jblang/TMS9918A/tmsmandel.jpg

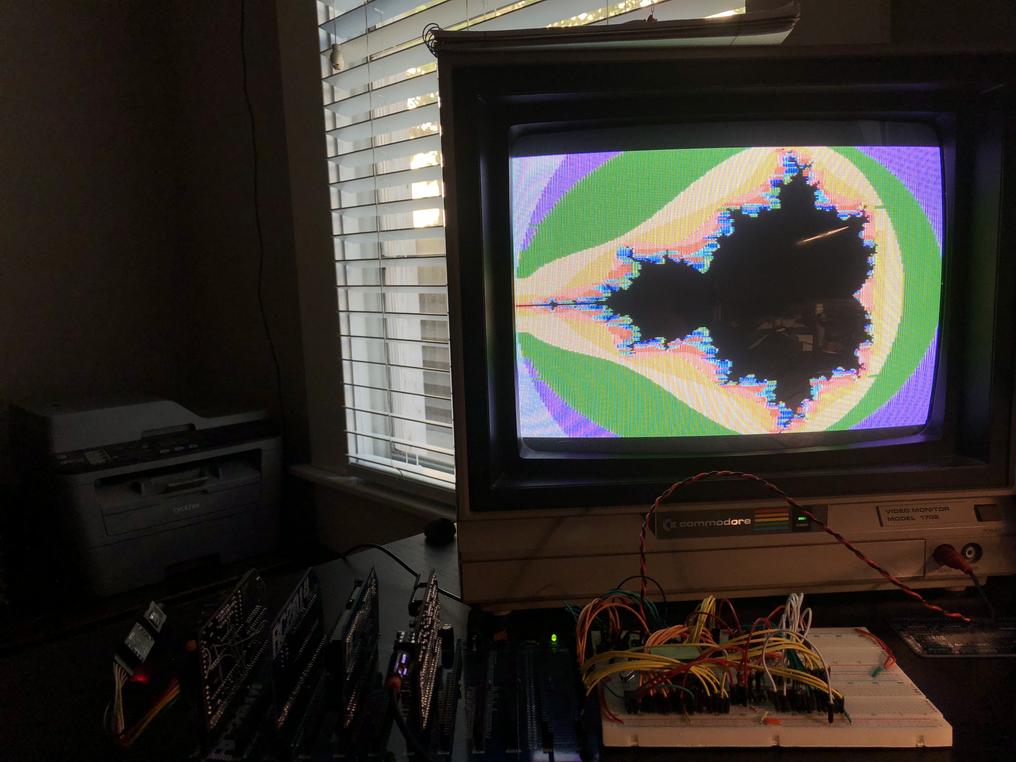
tmsmandel.jpg
