jblang/TMS9918A/(threads)

Thread 4 (2019-03-12):

Ask for clarification: why do we need a voltage buffer for COMVID

apoloval, 2019-03-12:
According to the schematic, there is a NPN, emitter-follower transistor circuit that seems to be there as a voltage buffer for COMVID signal.

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

Thanks to this buffer, we may have a low output impedance. However, according to the TMS9918 datasheet, the VDP already have a MOS source-follower that would do exactly the same the NPN is doing.

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

My question is, why do we need such NPN circuit for COMVID?

Thanks in advance for your help.

jblang, 2019-03-15:
As I stated in the README, I started with a circuit designed by [Tom LeMense](https://retrobrewcomputers.org/n8vem-pbwiki-archive/0/35845334/48860720/33053543/SRAM%20Replacement%20for%20TMS99x8%20VRAM.pdf) and simply added address decoding and laid it out on a PCB. I did not put much thought into why he designed the output stage the way he did; I just copied it verbatim. You are right that it may not be necessary.

apoloval, 2019-03-18:
Okay. Thank you so much for your response. It is really interesting, since most of the circuits I've seen using TMS9918 use a transistor at COMVID output. I will try to contact Tom to see if he could clarify this.

Again, thank you so much for your time! And congrats for this awesome project!

justinmoor, 2022-04-24:
Same question here. I've got a 100% working VDP with SRAM interfaced to a 6502 without the voltage buffer circuit or ferrite bead. COMVID is directly connected (with 470 ohm resistor) to the video input of the monitor (Sony PVM). Everything seems to be working fine. Any update on this?

apoloval, 2022-04-25:
I emailed Tom in 2019 asking the same question here. But I am afraid I received no response.

I still don't know why this output stage. But I also confirm I have working designs that do not have it.

cbmeeks, 2022-04-27:
For the record, I've also connected just a 330 ohm resistor from COMVID to GND and it worked just fine on a vanilla TV.  In fact, it was very colorful and vibrant.

apoloval, 2022-04-28:
In my case I am using 470 Ohms, also with nice results:

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

The design is open source, available in https://github.com/artemisamsx/gfx9918.

michaelkamprath, 2022-04-28:
Section 3.4.1 and 4.2.2 of [the TMS9918A spec](http://www1.cs.columbia.edu/~sedwards/papers/TMS9918.pdf) clearly states that in most cases, a 330 Ω or 470 Ω pull down resistor on the COMVID line is what is needed in most cases. But they also states that "in some cases it may be necessary to provide a simple interface circuit to match the monitor's input requirements." The use of the transistor on the COMVID line is that circuit, and it there as a simple precaution as it electrically isolates the rare, expensive, and no longer produced TMS9918A chip from external electrical interfaces. If the monitor draws more current than the TMS9918A can supply, well, that doesn't happen with the transistor circuit in this card's current design. Is it strictly needed? No. Does adding a 25 cent (if that) part provide some electrical isolation for the TMSD9918A chip? Yes.

apoloval, 2022-04-28:
I find the usage of the buffer for protection purposes convincing. Just wanted to know if there was anything else.

justinmoor, 2022-05-03:
Clear story. Thanks for commenting all!

Closed 2019-03-18.

Thread 6 (2020-09-19):

ym2149 jumper settings for nyan cat demo

quarterturn, 2020-09-19:
I have the nyan cat demo running on my Z180 ROMWBW "Black Adder" system but the audio from the YM2149 sounds way too low in pitch. The pace seems about right. What jumper settings on the YM2149 sound card did you use? I tried the default and the SC settings, but both work the same.

I  haven't yet tested the YM2149 board with other code, but I have tested the chip used in an Atmel setup where it plays ym stuff fine.

jblang, 2021-01-16:
I am using the REV6 of the YM2149 board that has its own 3.58MHz clock source.  If you have REV5 or earlier, you should configure your clock divider jumpers so that you can get the clock as close to 3.58MHz as possible based on the frequency of the system clock.

quarterturn, 2021-01-18:
Thank you I have resolved this by making a daughterboard for my YM2149 card that contains a 3.58 MHz oscillator. It works fine now.

Closed 2021-01-18.

Thread 9 (2021-01-16):

Operation with single-row RC2014 bus ?  (with possible answer...)

rwdavis3rd, 2021-01-16:
I'd looked forward to operating this TMS9918a video card as part of an SC130 (Z180) configuration.  I was a little disturbed to observe that video card made some use of (some-of) the second-row of RC2014 bus pins, which suggested it was not a fit for the single-row SC130 implementation.

After some study of the video card schematic, it appears that the video card taps the 2nd row simply for access to Z80's NMI.   And studying the cards jumper settings, I further learn that the use of NMI is usually only prescribed when _another_ board on the RC2014 bus is already using the conventional (maskable) INT signal.

jblang, or real-world testing, may prove me wrong, but... it appears that others (like me) who have single-row RC2014 "Z80" busses can proceed with confidence in most cases.  And for my part, if I later discover a need for the TMS9918a to tap the NMI line, I'll probably just float a wire to implement this signal path.

Sound right?

Thanks for any thoughts, and (_more_ importantly) thanks for making the venerated TMS9981 graphics readily accessible to geeks like me.

jblang, 2021-01-16:
Yes, it should work with only the single row header if you don't need NMI.  ColecoVision software requires the use of NMI, but if you don't care about that, you don't need it.

The INT line can be shared as long as you have REV4 of the board or later. It has a diode to convert the INT line to an open drain output.  That solves the hardware issue, but software in this case has to be programmed to check the registers of every device that might generate an interrupt to determine which one it has to service. Also, it is only compatible with the Z80's interrupt mode 1.

Thread 10 (2021-02-18):

What value did you use for the ferrite bead and R0 resistor?

cbmeeks, 2021-02-18:
I believe this is mostly based on the "SRAM Replacement" document for the TMS9918.  In that design, there is a ferrite bead used on VCC and the TMS9918.

I am building a similar design and was wondering what value you used?

Also, there is a 0 ohm resistor that is used in the original design.  Did you stick with 0 ohms or did you change it to something else?

Thanks

cbmeeks, 2022-04-27:
This can be closed.

I've been able to just use the reference design from TI (330 ohm resistor from COMVID to GND) with nothing else and it looks great.

Closed 2022-04-27.

Thread 12 (2022-10-15):

Modifying the Pageable ROM to work with ColecoVision addressing

ezod, 2022-10-15:
More a solution than an issue, but perhaps this could be added to the documentation somewhere. I have verified this modification works with some limited testing.

The standard RC2014 [Pageable ROM module](https://rc2014.co.uk/modules/pageable-rom/) canonically uses ports `$30` and `$38`, but due to don't-cares all of `$3x` and `$Bx` are assigned to it. Unfortunately, the `$Bx` range conflicts with the ColecoVision ports for the TMS9918A module.

A simple modification to the Pageable ROM module allows the ColecoVision ports to be used. To reduce the address range to just `$3x`, the enable pin on the decoder connected to A6 needs to be replaced with A6 OR A7.

In hardware, a 74HCT32 (quad OR), with all but pins 1, 2, 3, 7, and 14 removed, is piggy-backed on U1, with the power pins (7 and 14) soldered down. Pins 1, 2, and 3 are straightened horizontally for air soldering. Pins 1 and 2 are connected to A7 and A6 on the RC2014 bus, respectively. Pin 4 of U2 is bent out of the socket, and connected to pin 3 of the new 74HCT32.

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

ezod, 2022-10-17:
Confirmed today that this allows me to use @jblang's ColecoVision CP/M loader. (Still have no color video per #13, audio sounds like trash for as-yet unknown reasons, and I have no way to control the games yet, but at least we're past the address conflict!)

Thread 13 (2022-10-15):

No color on composite video output

ezod, 2022-10-15:
I built this module from parts sourced myself without difficulty, but the composite video signal is not displaying color, only grayscale.

A similar issue was discussed [here](https://www.msx.org/forum/msx-talk/hardware/tms9918-not-displaying-color) and [here](https://github.com/InPermutation/tms9918a-arduino/issues/1), and the eventual resolution had to do with the accuracy of the crystal frequency. Indeed, the exact crystal specified in the BOM is no longer available, and I used [this part from Mouser](https://www.mouser.ca/ProductDetail/ECS/ECS-107.3-S-4X?qs=CNVyLAqdhH3eznbdvp7RRg%3D%3D) instead, but based on the datasheets and other implementations this part looks like it should work. Michael Kamprath, who sells the Tindie kits, independently suggested this same part as a replacement. Its datasheet specifies a 20pF load capacitance; I tried the 16pF and 22pF caps I had on hand with the same result in both cases.

Another suggestion was that the TMS9918A (sourced from an eBay seller in China) might in fact be a relabeled TMS9928A or TMS9929A, as these output Y (luminance) on pin 36 instead of COMVID. Perhaps there is a way with just the chip I have to definitively determine whether this is the case? Unfortunately, for the moment, I do not have another TMS9918A on hand to try.

Is there anything else I should check that might be the problem here, before I try my luck with another month-plus wait for a TMS9918A?

apoloval, 2022-10-17:
> Another suggestion was that the TMS9918A (sourced from an eBay seller in China) might in fact be a relabeled TMS9928A or TMS9929A, as these output Y (luminance) on pin 36 instead of COMVID.

I bet for this one.

Do you have an oscilloscope? It is really easy to confirm if you had one.

apoloval, 2022-10-17:
You can make a particular test on pin 35. In TMS9918, this is the `EXTVDP` input signal. While in TMS9928/29 it is `B-Y`, an output signal that contains color information.

If you observe a plain zero signal in the oscilloscope, or a pure noise wave, your part is a TMS9918. If you observe a video-like waveform as the following one, it is a TMS9928/29:

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

ezod, 2022-10-17:
Pin 35 appears to just be a bit of white noise hovering near 5V. It definitely looks different than the signal on pin 36.

ezod, 2022-10-17:
Given that it seems I have a genuine TMS9918, I found [this thread](https://www.retrobrewcomputers.org/n8vem-gg-archive/html-2010/Jan/msg00049.html) discussing a similar issue, suggesting that the crystal frequency isn't the only potential issue. I've ordered a [MP107-E](https://www.digikey.ca/en/products/detail/cts-frequency-controls/MP107-E/2637557) parallel resonant crystal along with some 33pF capacitors (hopefully close enough to the specified 32pF), similar to the part that worked for the OP, and will update here if that works.

ezod, 2022-10-18:
And it works! Closing, but hopefully this will help anyone who encounters this issue in the future.

Closed 2022-10-18.

Thread 14 (2022-12-26):

Trimmer for crystal frequency fine tuning

eluancm, 2022-12-26:
A trimmer capacitor with a reasonable range instead of a fixed capacitor on the TMS9918A pin 40 would be useful to fine-tune the frequency and get good colors.

On one of my aged TVs, I need to put a finger on this pin to get any colors, regardless of fine tuning.
