jblang/TMS9918A/TMS9918.pdf

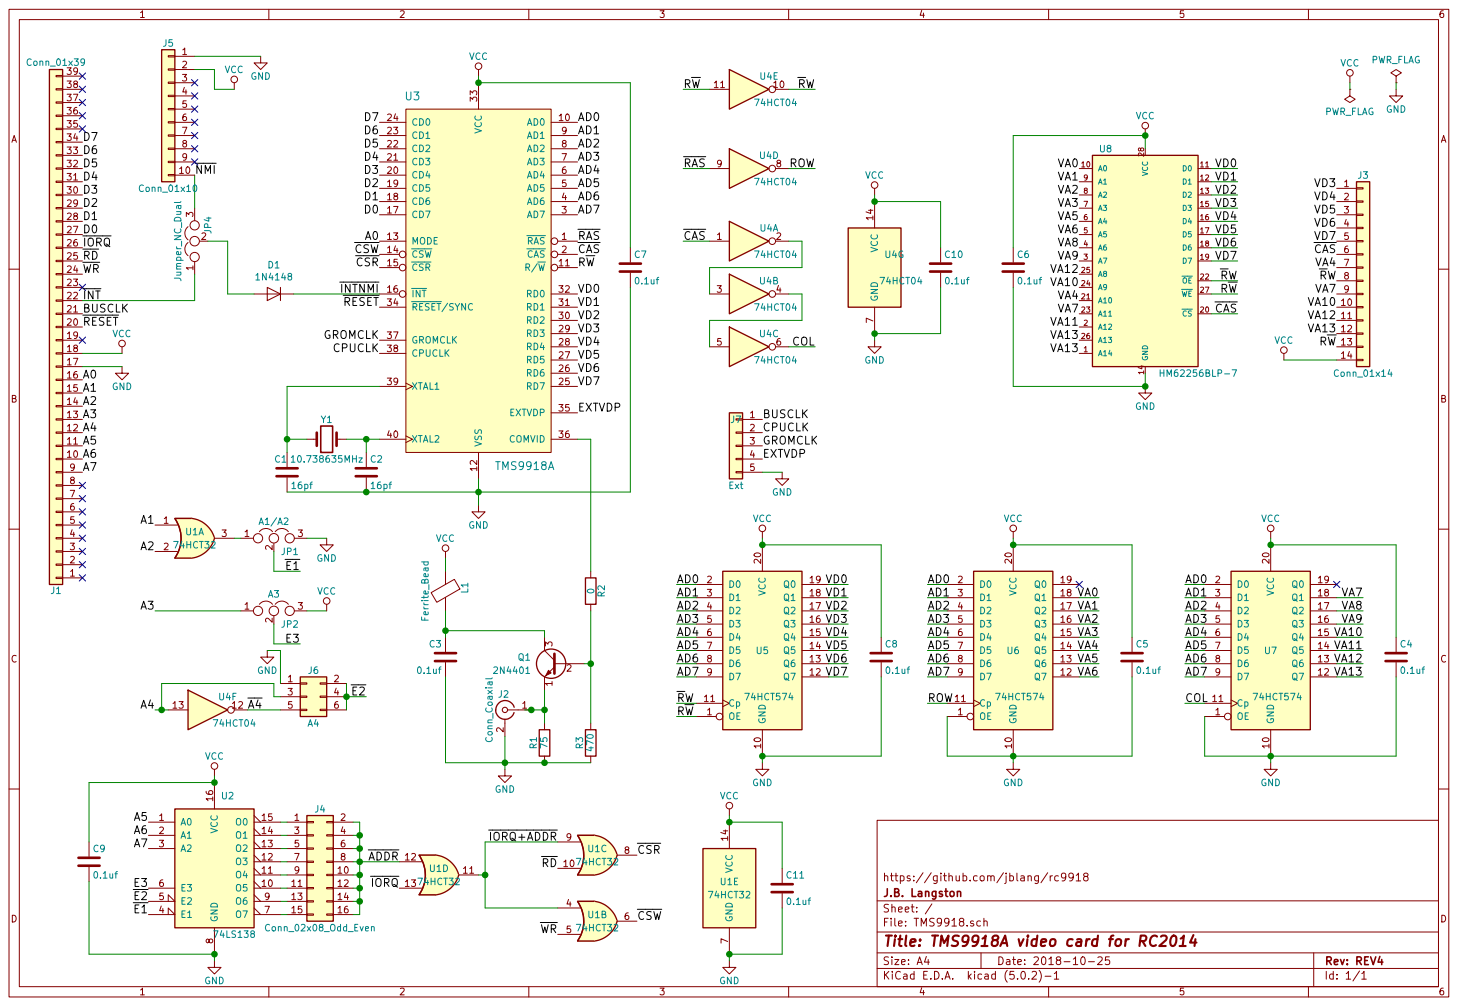
[picture p3: page 1]

https://github.com/jblang/rc9918
File: TMS9918.sch Sheet: / J.B. Langston

Id: 1/1 Title: TMS9918A video card for RC2014
