jblang/TMS9918A/examples/tmsfont.asm

; 6x8 bitmap font by Oleg Kosenkov
; Source: https://github.com/idispatch/raster-fonts/blob/master/font-6x8.c

        ; code=0, hex=0x00, ascii="^@"
        defb %00000000
        defb %00000000
        defb %00000000
        defb %00000000
        defb %00000000
        defb %00000000
        defb %00000000
        defb %00000000

        ; code=1, hex=0x01, ascii="^A"
        defb %00111000
        defb %01000100
        defb %01101100
        defb %01000100
        defb %01010100
        defb %01000100
        defb %00111000
        defb %00000000

        ; code=2, hex=0x02, ascii="^B"
        defb %00111000
        defb %01111100
        defb %01010100
        defb %01111100
        defb %01000100
        defb %01111100
        defb %00111000
        defb %00000000

        ; code=3, hex=0x03, ascii="^C"
        defb %00000000
        defb %00101000
        defb %01111100
        defb %01111100
        defb %01111100
        defb %00111000
        defb %00010000
        defb %00000000

        ; code=4, hex=0x04, ascii="^D"
        defb %00000000
        defb %00010000
        defb %00111000
        defb %01111100
        defb %01111100
        defb %00111000
        defb %00010000
        defb %00000000

        ; code=5, hex=0x05, ascii="^E"
        defb %00010000
        defb %00111000
        defb %00111000
        defb %00010000
        defb %01111100
        defb %01111100
        defb %00010000
        defb %00000000

        ; code=6, hex=0x06, ascii="^F"
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
        defb %01111000
        defb %00000000
        defb %00000000

        ; code=255, hex=0xFF, ascii="!^"
        defb %00000000
        defb %00000000
        defb %00000000
        defb %00000000
        defb %00000000
        defb %00000000
        defb %00000000
        defb %000000
