jblang/TMS9918A/(commit log)

2018-02-06 Adding kicad files
    [TMS9918.kicad_pcb, TMS9918.sch]
2018-02-06 Reduce via count
    [TMS9918.kicad_pcb]
2018-02-07 Move video output to other end of board
    [TMS9918.kicad_pcb, TMS9918.sch]
2018-02-08 Updated for wide-body SRAM
    [TMS9918.kicad_pcb, TMS9918.sch]
2018-02-09 Add OR gates and reroute
    [TMS9918.kicad_pcb, TMS9918.sch]
2018-02-11 Switch RCA footprint, minor cleanup
    [TMS9918.kicad_pcb, TMS9918.sch]
2018-06-10 Fix address decoding
    [TMS9918.kicad_pcb, TMS9918.sch]
2018-06-11 Add address selection jumper
    [TMS9918.kicad_pcb, TMS9918.sch]
2018-06-15 Generate REV1 files
    [TMS9918.kicad_pcb]
2018-06-17 Fix missing library
    [TMS9918.kicad_pcb, TMS9918.sch]
2018-07-04 Correct crystal/load cap values
    [TMS9918.sch]
2018-07-04 Rearrange nyan assembly
2018-07-05 Add assembler output files to .gitignore
2018-07-05 Add separate interrupt enable and color setting functions
2018-07-24 REV2 changes; see Hackaday for details
    [TMS9918.kicad_pcb, TMS9918.sch]
2018-07-26 Via reduction
    [TMS9918.kicad_pcb]
2018-07-27 Zero Vias: OCD Triumps!
    [TMS9918.kicad_pcb, TMS9918.sch]
2018-07-27 Got carried away; add back a few vias
    [TMS9918.kicad_pcb, TMS9918.sch]
2018-07-28 Tweaks to improve ground plane
    [TMS9918.kicad_pcb]
2018-08-14 Fix incorrect A3 decoding
    [TMS9918.kicad_pcb, TMS9918.sch]
2018-10-25 Upgrade to KiCad 5.0
    [TMS9918.kicad_pcb, TMS9918.sch]
2018-11-02 REV4 Tweaks
    [TMS9918.kicad_pcb, TMS9918.sch]
2018-11-13 Fix overlapping silkscreen
    [TMS9918.kicad_pcb]
2019-01-12 Update README and Schematic for REV4
    [TMS9918.sch]
2019-01-29 Update assembly syntax for cross-assembler compatibility
2019-01-29 Don't re-enable interrupt until end of interupt handler
2019-01-29 Fix text centering bug
    [ascii.asm]
2020-05-08 Simplify tmswait so that it specifies the literal number of nops to insert
2020-05-08 Fix stack so it doesn't clobber CP/M
    [ascii.asm, mandel.asm]
2020-05-10 Improve stack and interrupt handling
2020-05-10 Disable VDP interrupts before returning to CP/M
2020-05-27 Disable interrupts and remove BDOS input check
2020-05-28 Switch from jr to jp so more padding can be added
2020-05-28 Use vsync polling instead of interrupts
2020-05-30 Fix arkos incompatibility with Z180
    [nyan.asm]
2020-06-06 Switch nyan theme from Arkos to PT3
2020-06-09 Fix jerky movement of globe
    [sprite.asm]
2020-06-10 Refactor TMS initialization, switch to camel case identifiers
2020-06-16 Fix compilation errors with z88dk
    [PT3.asm]
2020-08-22 Avoid redundant Y calculations
    [plasma.asm]
2020-08-30 Switch to sine routines from Plascii Petsma
2020-08-31 Switch to plasma effect from Plascii Petsma by Cruzer/Camelot
2020-09-13 Gerber tweaks
    [TMS9918.kicad_pcb]
2022-10-22 Upgrade Kicad projects to v6
    [TMS9918.kicad_pcb, TMS9918.kicad_sch, TMS9918.sch]
