jblang/TMS9918A/(notices)

Notices in the files:
TMS9918.kicad_pcb:
(c) 2018 J.B. Langston
